mozee-motorsports/inverter-control-board/README.md

# mp7_ied (isolation-expansion-device)

Isolated CAN-addressable analog throttle for Sevcon.

- firmware in `src/`
  - to build: install Raspberry Pi Pico extension in vscode, open folder, click compile on bottom bar. 
- kicad project in `pcb/`
