mozee-motorsports/inverter-control-board/pcb/output/motorboard.step

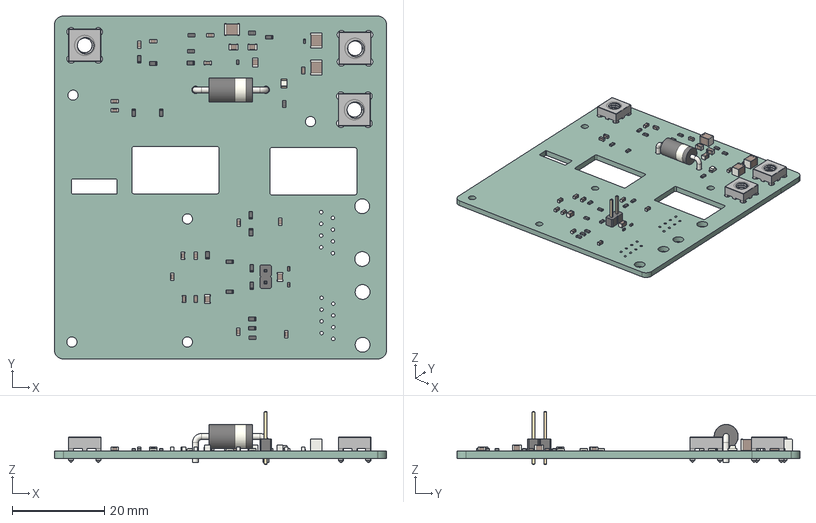
[picture p1: CAD file, 2025-04-10]
pcb/output/motorboard.step
72.0 x 74.3 x 11.5 mm
R_0603_1608Metric x 20
D_DO-201AD_P15.24mm_Horizontal
C_0603_1608Metric x 16
Wuerth_REDCUBE-THR_WP-THRBU_74650074_THR x 3
C_1210_3225Metric x 3
C_0805_2012Metric x 5
C_0402_1005Metric x 2
LED_0805_2012Metric
PinHeader_1x02_P254mm_Vertical
R_0402_1005Metric x 2
motorboard_PCB
