mozee-motorsports/inverter-control-board/todo.md

- [ ] output filtering on TSV 12V (LDO, LC filter?)
- [ ] Swap I2C for SPI
- [ ] rest of circuit
