mozee-motorsports/inverter-control-board/resources/Buck_Converter_Design_Report.pdf

## WEBENCH ® Design Report

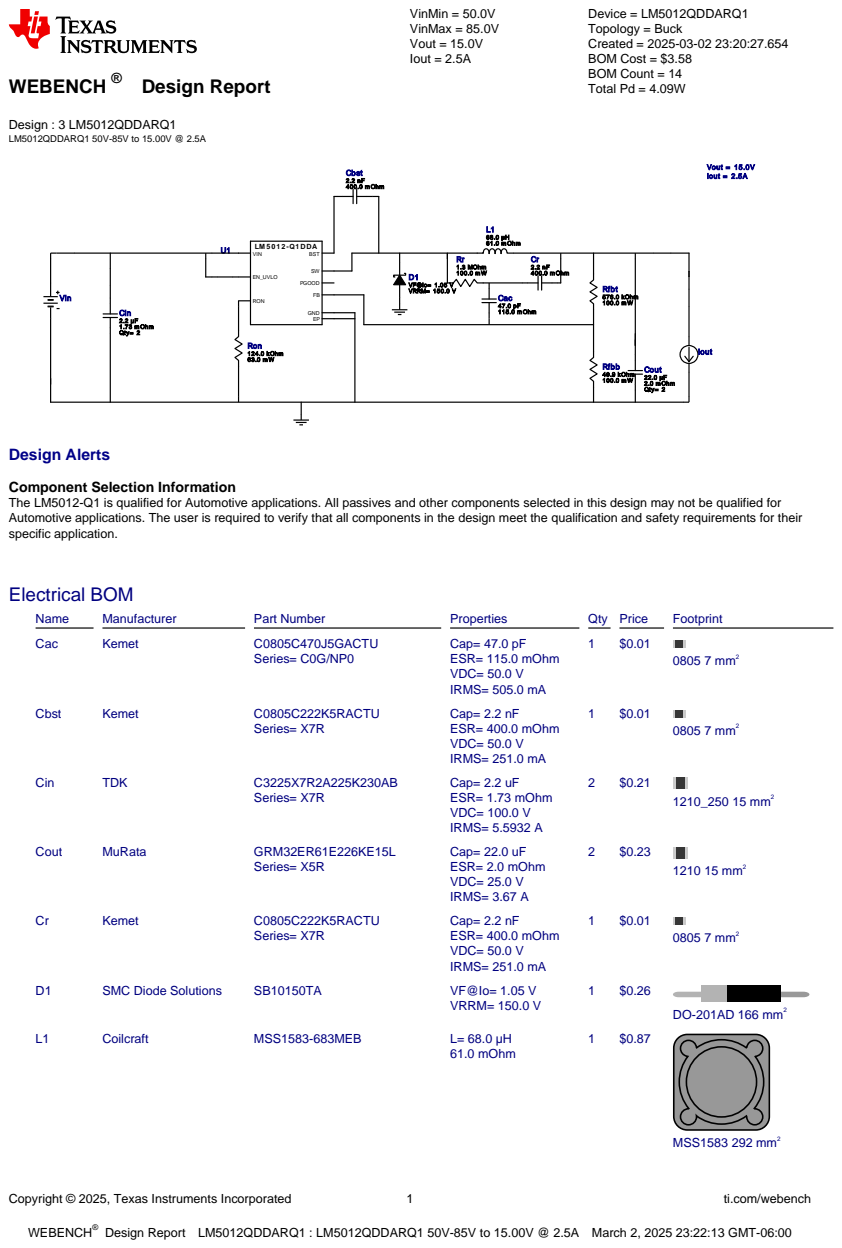
[picture p2: page 1]
Copyright © 2025, Texas Instruments Incorporated; ti.com/webench; WEBENCH®; Design : 3 LM5012QDDARQ1 LM5012QDDARQ1 50V-85V to 15.00V @ 2.5A; VinMin = 50.0V VinMax = 85.0V Vout = 15.0V Iout = 2.5A; Device = LM5012QDDARQ1 Topology = Buck Created = 2025-03-02 23:20:27.654 BOM Cost = $3.58 BOM Count = 14 Total Pd = 4.09W; Cbst 2.2 nF 400.0 m Ohm; LM 5 0 1 2 -Q1 DDA; GND; VIN; EN_UVLO; RON; PGOOD; BST; Cac 47.0 pF 115.0 m Ohm; Rr 1.3 MOhm 100.0 m W; Cr 2.2 nF 400.0 m Ohm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

Component Selection Information
The LM5012-Q1 is qualified for Automotive applications. All passives and other components selected in this design may not be qualified for
Automotive applications. The user is required to verify that all components in the design meet the qualification and safety requirements for their
specific application.

Design Report LM5012QDDARQ1 : LM5012QDDARQ1 50V-85V to 15.00V @ 2.5A March 2, 2025 23:22:13 GMT-06:00

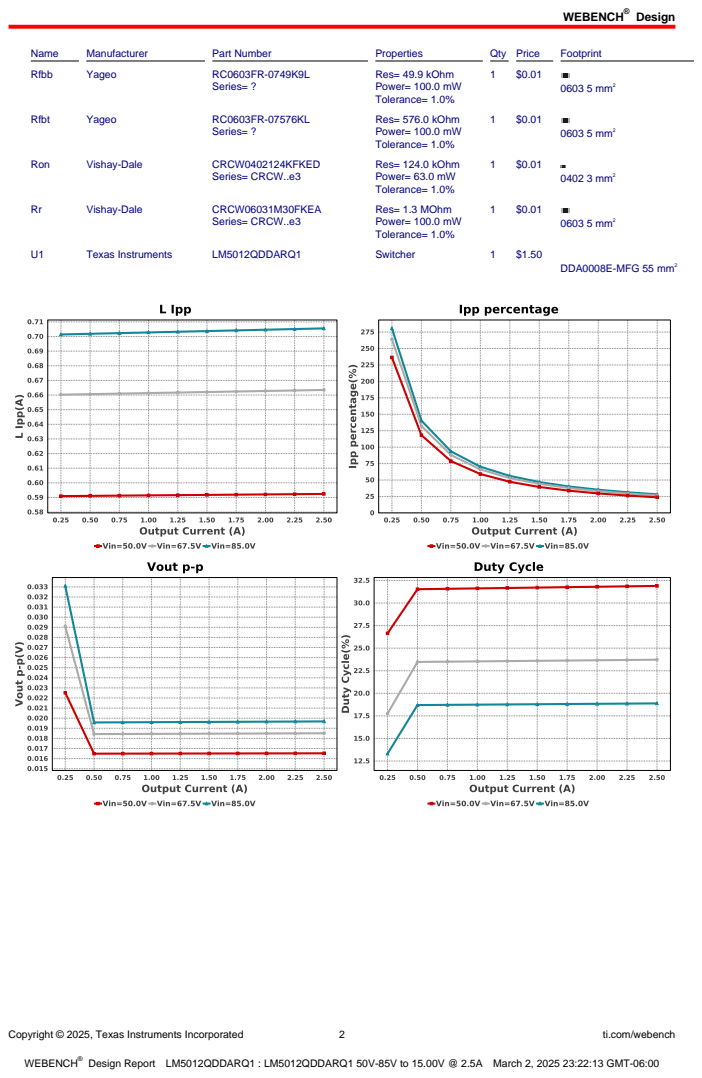
[picture p3: page 2]
Design; Copyright © 2025, Texas Instruments Incorporated; ti.com/webench; Name; Manufacturer; Part Number; Properties; Qty Price; Footprint; Rfbb; Yageo; Series= ?; Res= 49.9 kOhm Power= 100.0 mW Tolerance= 1.0%; 0603 5 mm²; Rfbt; Res= 576.0 kOhm Power= 100.0 mW Tolerance= 1.0%; Ron; Vishay-Dale; CRCW0402124KFKED; Series= CRCW..e3; Res= 124.0 kOhm Power= 63.0 mW Tolerance= 1.0%; 0402 3 mm²; CRCW06031M30FKEA; Res= 1.3 MOhm Power= 100.0 mW Tolerance= 1.0%; Texas Instruments; LM5012QDDARQ1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

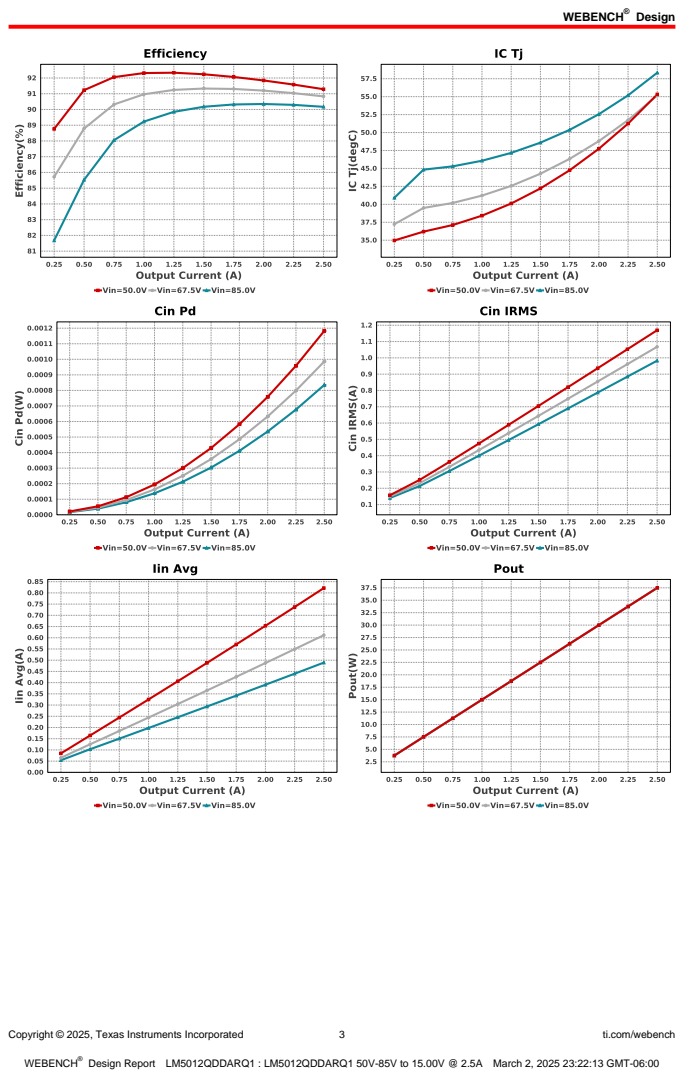
[picture p4: page 3]
Copyright © 2025, Texas Instruments Incorporated; ti.com/webench

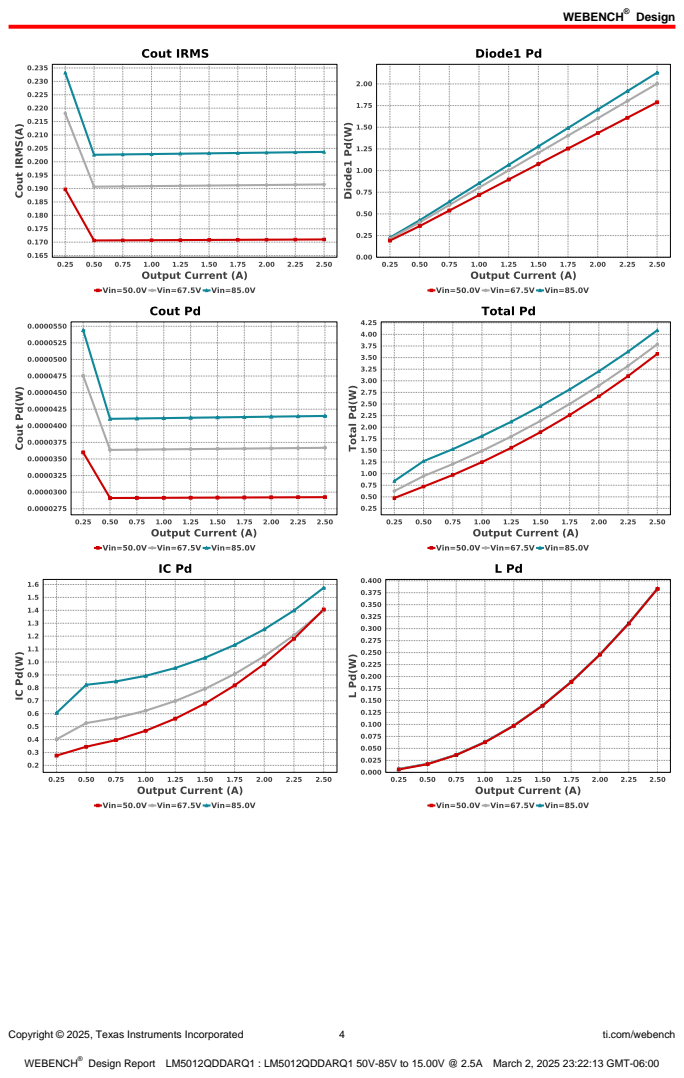
[picture p5: page 4]
Copyright © 2025, Texas Instruments Incorporated; ti.com/webench

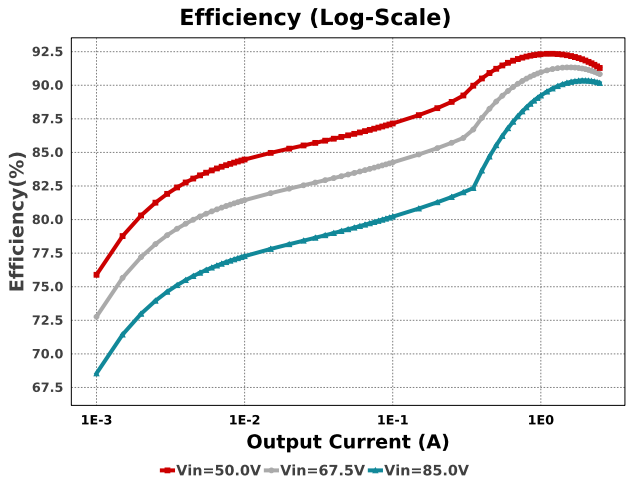
[picture p6: figure]

Copyright © 2025, Texas Instruments Incorporated | 5 | ti.com/webench

## Operating Values

# | Name | Value | Category | Description

1. Cin IRMS | 982.444 mA | Capacitor | Input capacitor RMS ripple current
2. Cin Pd | 834.89 µW | Capacitor | Input capacitor power dissipation
3. Cout IRMS | 203.681 mA | Capacitor | Output capacitor RMS ripple current
4. Cout Pd | 41.486 µW | Capacitor | Output capacitor power dissipation
5. Diode1 Pd | 2.129 W | Diode | Diode1 power dissipation
6. IC Pd | 1.574 W | IC | IC power dissipation
7. IC Tj | 58.336 degC | IC | IC junction temperature
8. IC Tolerance | 19.0 mV | IC | IC Feedback Tolerance
9. ICThetaJA | 18.0 degC/W | IC | IC junction-to-ambient thermal resistance
10. Iin Avg | 489.28 mA | IC | Average input current
11. Ipp percentage | 28.223 % | Inductor | Inductor ripple current percentage (with respect to average inductor
| | | | current)
12. L Ipp | 705.57 mA | Inductor | Peak-to-peak inductor ripple current
13. L Pd | 383.78 mW | Inductor | Inductor power dissipation
14. Cin Pd | 834.89 µW | Power | Input capacitor power dissipation
15. Cout Pd | 41.486 µW | Power | Output capacitor power dissipation
16. Diode1 Pd | 2.129 W | Power | Diode1 power dissipation
17. IC Pd | 1.574 W | Power | IC power dissipation
18. L Pd | 383.78 mW | Power | Inductor power dissipation
19. Total Pd | 4.089 W | Power | Total Power Dissipation
20. BOM Count | 14 | System
| | | Information | Total Design BOM count
21. Duty Cycle | 18.884 % | System
| | | Information | Duty cycle
22. Efficiency | 90.169 % | System
| | | Information | Steady state efficiency
23. FootPrint | 610.0 mm² | System
| | | Information | Total Foot Print Area of BOM components
24. Frequency | 273.931 kHz | System
| | | Information | Switching frequency
25. Iout | 2.5 A | System
| | | Information | Iout operating point
26. Mode | CCM | System
| | | Information | Conduction Mode
27. Pout | 37.5 W | System
| | | Information | Total output power
28. Total BOM | $3.58 | System
| | | Information | Total BOM Cost
29. Vin | 85.0 V | System
| | | Information | Vin operating point
30. Vout | 15.0 V | System
| | | Information | Operational Output Voltage
31. Vout Actual | 15.052 V | System
| | | Information | Vout Actual calculated based on selected voltage divider resistors
32. Vout Tolerance | 3.472 % | System
| | | Information | Vout Tolerance based on IC Tolerance (no load) and voltage divider resistors if applicable
33. Vout p-p | 19.682 mV | System
| | | Information | Peak-to-peak output ripple voltage

## Design Inputs

Copyright © 2025, Texas Instruments Incorporated | 6 | ti.com/webench
Name | Value | Description
Iout | 2.5 | Maximum Output Current
VinMax | 85.0 | Maximum input voltage
VinMin | 50.0 | Minimum input voltage
Vout | 15.0 | Output Voltage
base_pn | LM5012-Q1 | Base Product Number
source | DC | Input Source Type
Ta | 30.0 | Ambient temperature


Copyright © 2025, Texas Instruments Incorporated | 7 | ti.com/webench

## Assembly

## Component Testing

Some published data on components in datasheets such as Capacitor ESR and Inductor DC resistance is based on conservative values that will guarantee that the components always exceed the specification. For design purposes it is usually better to work with typical values. Since this data is not always available it is a good practice to measure the Capacitance and ESR values of Cin and Cout, and the inductance and DC resistance of L1 before assembly of the board. Any large discrepancies in values should be electrically simulated in WEBENCH to check for instabilities and thermally simulated in WebTHERM to make sure critical temperatures are not exceeded.

## Soldering Component to Board

If board assembly is done in house it is best to tack down one terminal of a component on the board then solder the other terminal. For surface mount parts with large tabs, such as the DPAK, the tab on the back of the package should be pre-tinned with solder, then tacked into place by one of the pins. To solder the tab town to the board place the iron down on the board while resting against the tab, heating both surfaces simultaneously. Apply light pressure to the top of the plastic case until the solder flows around the part and the part is flush with the PCB. If the solder is not flowing around the board you may need a higher wattage iron (generally 25W to 30W is enough).

## Initial Startup of Circuit

It is best to initially power up the board by setting the input supply voltage to the lowest operating input voltage 50.0V and set the input supply's current limit to zero. With the input supply off connect up the input supply to Vin and GND. Connect a digital volt meter and a load if needed to set the minimum Iout of the design from Vout and GND. Turn on the input supply and slowly turn up the current limit on the input supply.
If the voltage starts to rise on the input supply continue increasing the input supply current limit while watching the output voltage. If the current increases on the input supply, but the voltage remains near zero, then there may be a short or a component misplaced on the board. Power down the board and visually inspect for solder bridges and recheck the diode and capacitor polarities. Once the power supply circuit is operational then more extensive testing may include full load testing, transient load and line tests to compare with simulation results.

## Load Testing

The setup is the same as the initial startup, except that an additional digital voltmeter is connected between Vin and GND, a load is connected between Vout and GND and a current meter is connected in series between Vout and the load. The load must be able to handle at least rated output power + 50% ( 7.5 watts for this design). Ideally the load is supplied in the form of a variable load test unit. It can also be done in the form of suitably large power resistors. When using an oscilloscope to measure waveforms on the prototype board, the ground leads of the oscilloscope probes should be as short as possible and the area of the loop formed by the ground lead should be kept to a minimum. This will help reduce ground lead inductance and eliminate EMI noise that is not actually present in the circuit.

## Design Assistance

1. The LM5012-Q1 is qualified for Automotive applications. All passives and other components selected in this design may not be qualified for Automotive applications. The user is required to verify that all components in the design meet the qualification and safety requirements for their specific application
2. Master key : 540540835BFE532DA29369383AB8C5E5[v1]
3. LM5012-Q1 Product Folder : http://www.ti.com/product/LM5012%2DQ1 : contains the data sheet and other resources.

Copyright © 2025, Texas Instruments Incorporated | 8 | ti.com/webench

Important Notice and Disclaimer

TI provides technical and reliability data (including datasheets), design resources (including reference designs), application or other design advice, web tools, safety information, and other resources AS IS and with all faults, and disclaims all warranties. These resources are intended for skilled developers designing with TI products. You are solely responsible for (1) selecting the appropriate TI products for your application, (2) designing, validating and testing your application, and (3) ensuring your application meets applicable standards, and any other safety, security, or other requirements.

These resources are subject to change without notice. TI grants you permission to use these resources only for development of an application that uses the TI products described in the resource. Other reproduction and display of these resources is prohibited. No license is granted to any other TI intellectual property right or to any third party intellectual property right. TI disclaims responsibility for, and you will fully indemnify TI and its representatives against, any claims, damages, costs, losses, and liabilities arising out of your use of these resources.

Providing these resources does not expand or otherwise alter TI's applicable Terms of Sale or other applicable terms available either on ti.com or provided in conjunction with TI products.
