mozee-motorsports/inverter-control-board/pcb/motorboard.kicad_pcb

## KiCad design pcb/motorboard.kicad_pcb (2025-04-21)

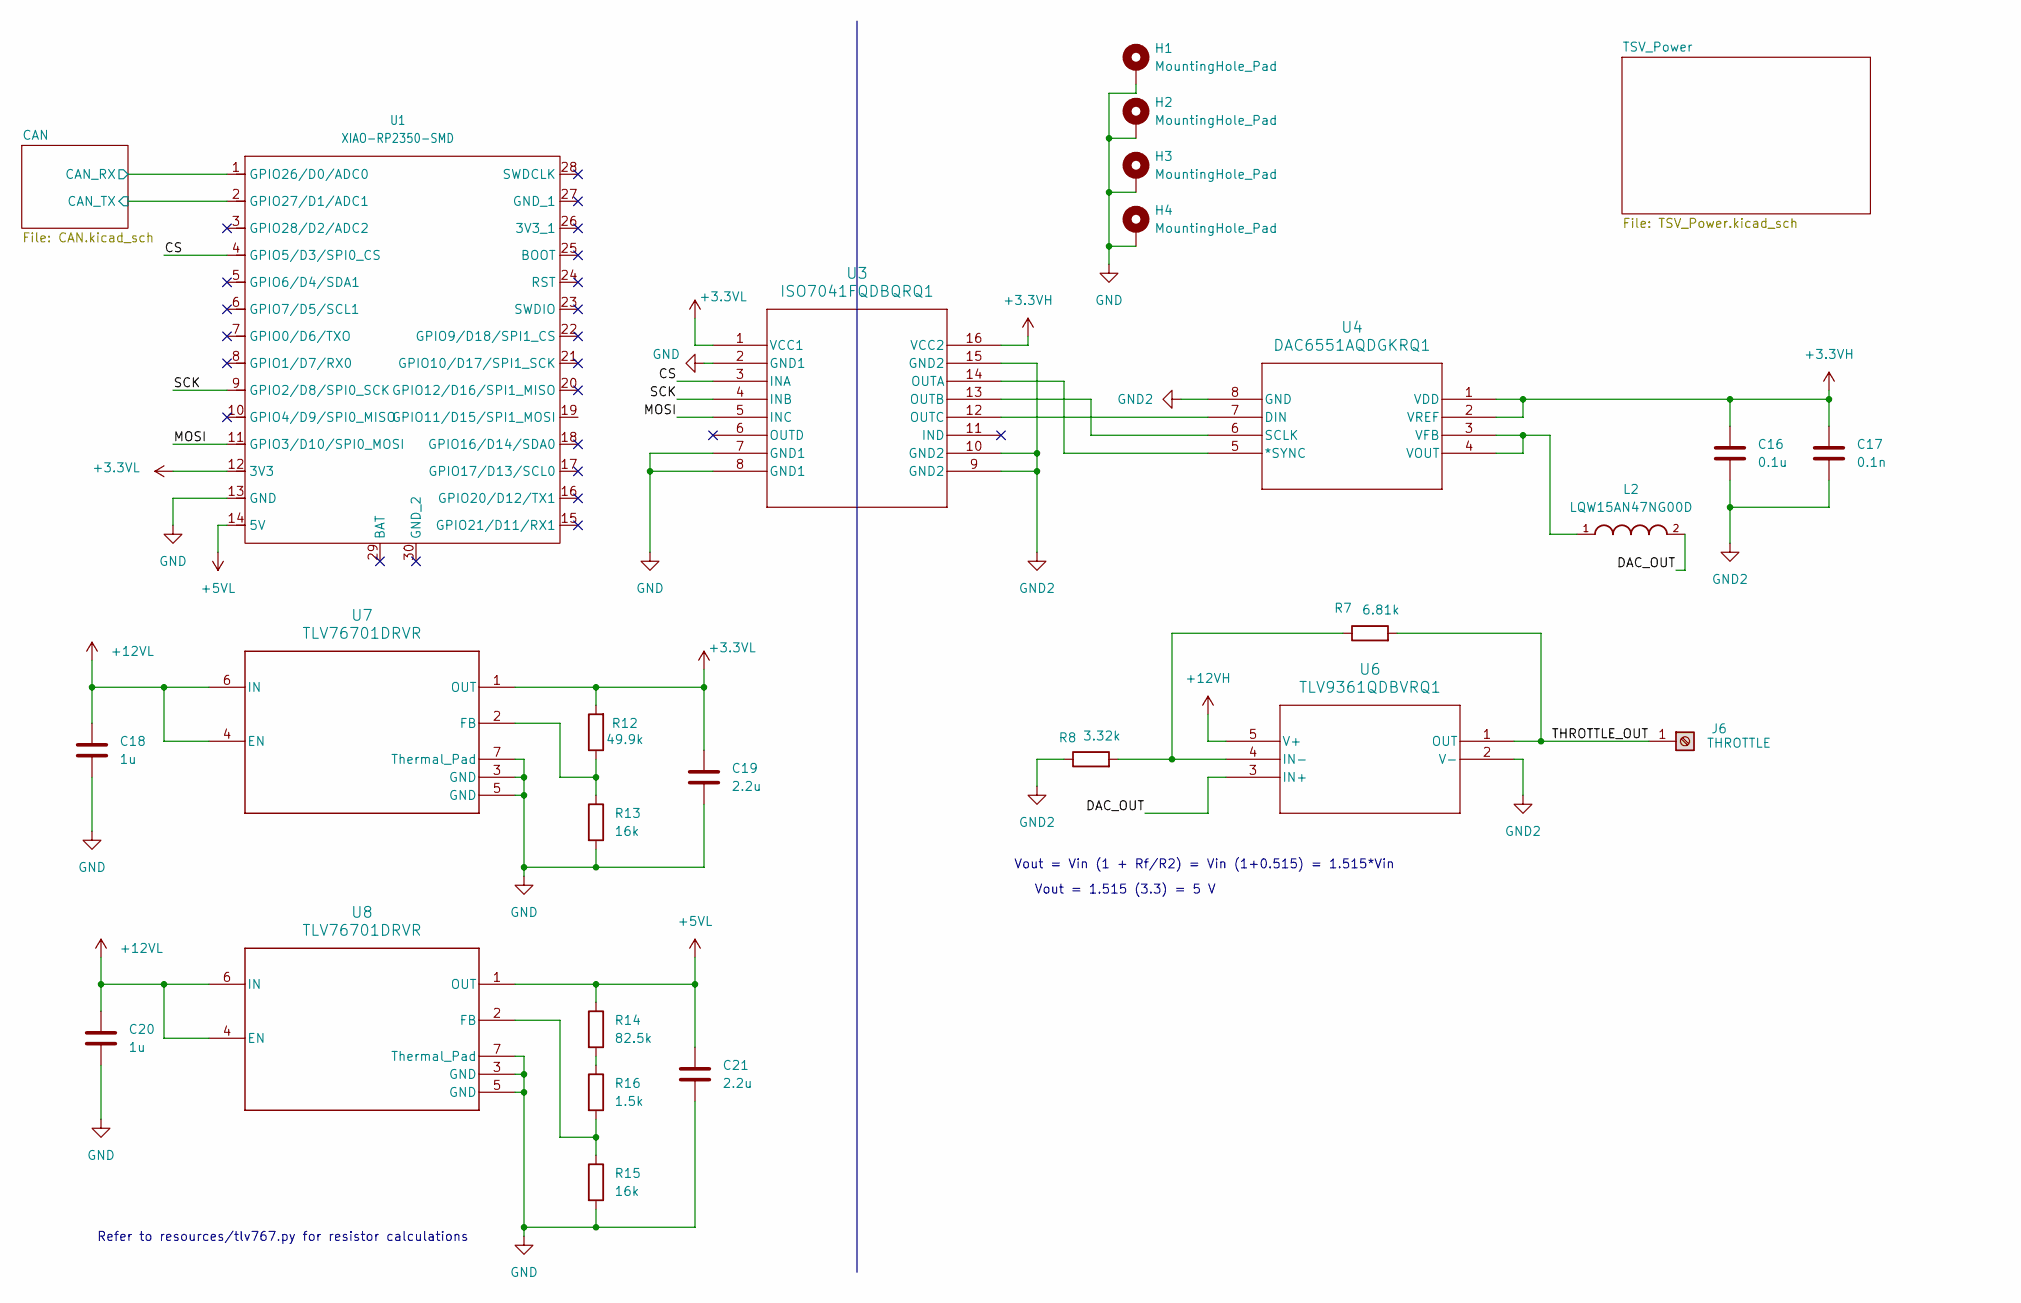
[picture p8: schematic motorboard.kicad_sch]

Parts:
C16: 0.1u; C_0603_1608Metric
C17: 0.1n; C_0603_1608Metric
C18, C20: 1u; C_0603_1608Metric
C19, C21: 2.2u; C_0603_1608Metric
H1, H2, H3, H4: MountingHole_Pad; MountingHole_2.2mm_M2
J6: THROTTLE; Wuerth_REDCUBE-THR_WP-THRBU_74650074_THR
L2: LQW15AN47NG00D; INDC1005X60N
R7: 6.81k; R_0603_1608Metric
R8: 3.32k; R_0603_1608Metric
R12: 49.9k; R_0603_1608Metric
R13, R15: 16k; R_0603_1608Metric
R14: 82.5k; R_0603_1608Metric
R16: 1.5k; R_0603_1608Metric
U1: XIAO-RP2350-SMD
U3: ISO7041FQDBQRQ1; SSOP16_DBQ_TEX
U4: DAC6551AQDGKRQ1; DGK8_TEX
U6: TLV9361QDBVRQ1; SOT23_DBV_TEX
U7, U8: TLV76701DRVR; DRV0006A-IPC_A

Connections:
+3.3VH: C16.1, C17.1, U3.16 (VCC2), U4.1 (VDD), U4.2 (VREF); also elsewhere on the board
+3.3VL: C19.1, R12.2, U1.12 (3V3), U3.1 (VCC1), U7.1 (OUT); also elsewhere on the board
+5VL: C21.1, R14.1, U1.14 (5V), U8.1 (OUT); also elsewhere on the board
+12VH: U6.5 (V+); also elsewhere on the board
+12VL: C18.1, C20.1, U7.4 (EN), U7.6 (IN), U8.4 (EN), U8.6 (IN); also elsewhere on the board
/CAN/CAN_RX: U1.1 (GPIO26/D0/ADC0); also elsewhere on the board
/CAN/CAN_TX: U1.2 (GPIO27/D1/ADC1); also elsewhere on the board
/CS: U1.4 (GPIO5/D3/SPI0_CS), U3.3 (INA)
/DAC_OUT: L2.2, U6.3 (IN+)
/MOSI: U1.11 (GPIO3/D10/SPI0_MOSI), U3.5 (INC)
/SCK: U1.9 (GPIO2/D8/SPI0_SCK), U3.4 (INB)
/THROTTLE_OUT: J6.1, R7.2, U6.1 (OUT)
GND: C18.2, C19.2, C20.2, C21.2, H1.1, H2.1, H3.1, H4.1, R13.2, R15.2, U1.13 (GND), U3.2 (GND1), U3.7 (GND1), U3.8 (GND1), U7.3 (GND), U7.5 (GND), U7.7 (Thermal_Pad), U8.3 (GND), U8.5 (GND), U8.7 (Thermal_Pad); also elsewhere on the board
GND2: C16.2, C17.2, R8.1, U3.9 (GND2), U3.10 (GND2), U3.15 (GND2), U4.8 (GND), U6.2 (V-); also elsewhere on the board
unnamed: R14.2, R16.1
unnamed: U3.14 (OUTA), U4.5 (*SYNC)
unnamed: U3.13 (OUTB), U4.6 (SCLK)
unnamed: U3.12 (OUTC), U4.7 (DIN)
unnamed: L2.1, U4.3 (VFB), U4.4 (VOUT)
unnamed: R7.1, R8.2, U6.4 (IN-)
unnamed: R12.1, R13.1, U7.2 (FB)
unnamed: R15.1, R16.2, U8.2 (FB)

Notes on the sheet:
Vout = 1.515 (3.3) = 5 V
Refer to resources/tlv767.py for resistor calculations
Vout = Vin (1 + Rf/R2) = Vin (1+0.515) = 1.515*Vin

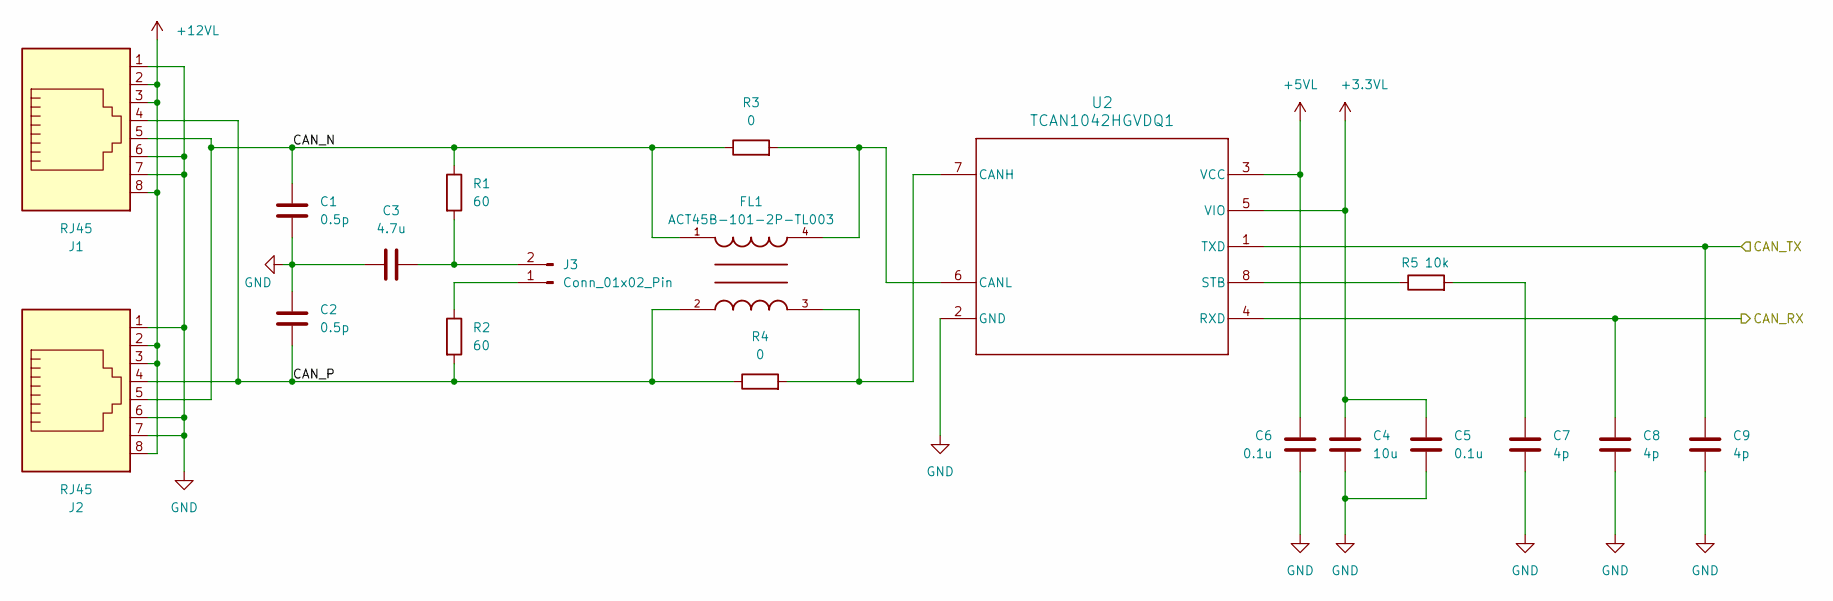
[picture p9: schematic CAN.kicad_sch]

Parts:
C1, C2: 0.5p; C_0402_1005Metric
C3: 4.7u; C_0805_2012Metric
C4: 10u; C_0805_2012Metric
C5, C6: 0.1u; C_0603_1608Metric
C7, C8, C9: 4p; C_0603_1608Metric
FL1: ACT45B-101-2P-TL003; FIL_ACT45B-101-2P-TL003; PARTREV 20200405
J1, J2: RJ45; RJ45_Amphenol_54602-x08_Horizontal
J3: Conn_01x02_Pin; PinHeader_1x02_P2.54mm_Vertical
R1, R2: 60; R_0603_1608Metric
R3, R4: 0; R_0603_1608Metric
R5: 10k; R_0603_1608Metric
U2: TCAN1042HGVDQ1; D0008A_L

Connections:
+3.3VL: C4.1, C5.1, U2.5 (VIO); also elsewhere on the board
+5VL: C6.2, U2.3 (VCC); also elsewhere on the board
+12VL: J1.2, J1.3, J1.8, J2.2, J2.3, J2.8; also elsewhere on the board
/CAN/CAN_N: C1.2, FL1.1, J1.5, J2.5, R1.1, R3.1
/CAN/CAN_P: C2.1, FL1.2, J1.4, J2.4, R2.2, R4.1
/CAN/CAN_RX: C8.1, U2.4 (RXD); also elsewhere on the board
/CAN/CAN_TX: C9.1, U2.1 (TXD); also elsewhere on the board
GND: C1.1, C2.2, C3.2, C4.2, C5.2, C6.1, C7.2, C8.2, C9.2, J1.1, J1.6, J1.7, J2.1, J2.6, J2.7, U2.2 (GND); also elsewhere on the board
unnamed: C7.1, R5.2
unnamed: J3.1, R2.1
unnamed: C3.1, J3.2, R1.2
unnamed: FL1.3, R4.2, U2.7 (CANH)
unnamed: FL1.4, R3.2, U2.6 (CANL)
unnamed: R5.1, U2.8 (STB)

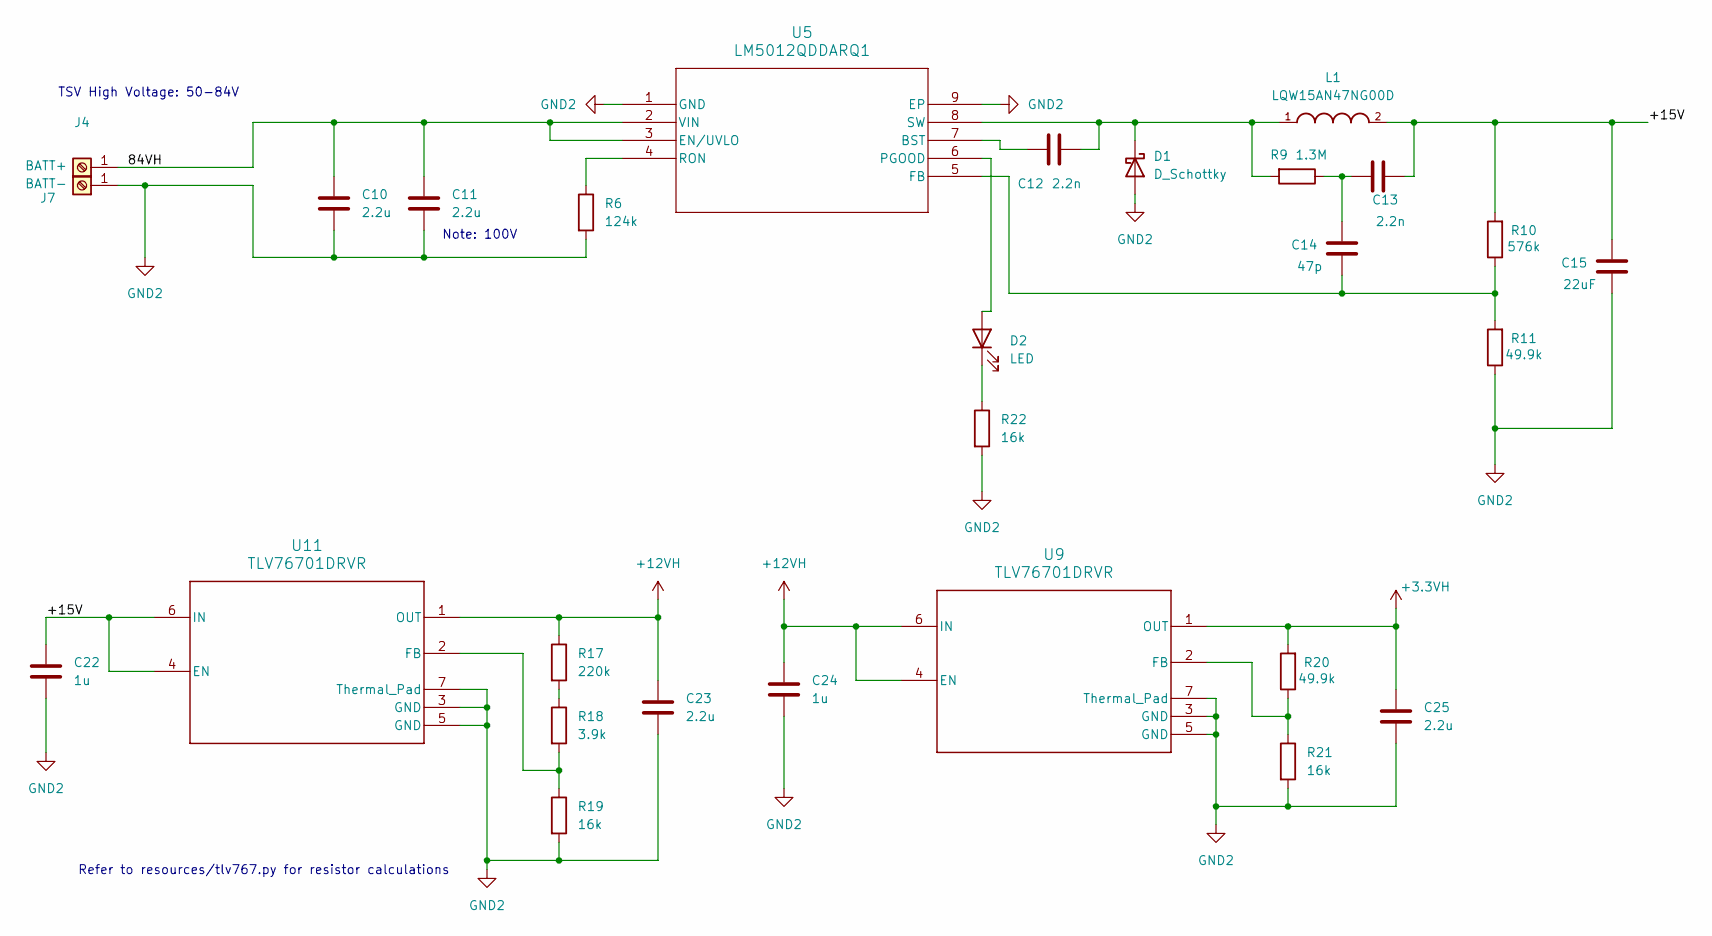
[picture p10: schematic TSV_Power.kicad_sch]

Parts:
C10, C11: 2.2u; C_1210_3225Metric_Pad1.33x2.70mm_HandSolder
C12, C13: 2.2n; C_0805_2012Metric
C14: 47p; C_0805_2012Metric
C15: 22uF; C_1210_3225Metric
C22, C24: 1u; C_0603_1608Metric
C23, C25: 2.2u; C_0603_1608Metric
D1: D_Schottky; D_DO-201AD_P15.24mm_Horizontal
D2: LED; LED_0805_2012Metric
J4: BATT+; Wuerth_REDCUBE-THR_WP-THRBU_74650074_THR
J7: BATT-; Wuerth_REDCUBE-THR_WP-THRBU_74650074_THR
L1: LQW15AN47NG00D; INDC1005X60N
R6: 124k; R_0402_1005Metric
R9: 1.3M; R_0402_1005Metric_Pad0.72x0.64mm_HandSolder
R10: 576k; R_0603_1608Metric
R11, R20: 49.9k; R_0603_1608Metric
R17: 220k; R_0603_1608Metric
R18: 3.9k; R_0603_1608Metric
R19, R21, R22: 16k; R_0603_1608Metric
U5: LM5012QDDARQ1; SO-8-DDA_TEX
U9, U11: TLV76701DRVR; DRV0006A-IPC_A

Connections:
+3.3VH: C25.1, R20.2, U9.1 (OUT); also elsewhere on the board
+12VH: C23.1, C24.1, R17.1, U9.4 (EN), U9.6 (IN), U11.1 (OUT); also elsewhere on the board
/TSV_Power/84VH: C10.1, C11.1, J4.1, U5.2 (VIN), U5.3 (EN/UVLO); also elsewhere on the board
/TSV_Power/+15V: C13.2, C15.1, C22.1, L1.2, R10.2, U11.4 (EN), U11.6 (IN)
GND2: C10.2, C11.2, C15.2, C22.2, C23.2, C24.2, C25.2, D1.2 (A), J7.1, R6.2, R11.1, R19.2, R21.2, R22.2, U5.1 (GND), U5.9 (EP), U9.3 (GND), U9.5 (GND), U9.7 (Thermal_Pad), U11.3 (GND), U11.5 (GND), U11.7 (Thermal_Pad); also elsewhere on the board
unnamed: C13.1, C14.1, R9.1
unnamed: C12.2, D1.1 (K), L1.1, R9.2, U5.8 (SW)
unnamed: D2.2 (A), U5.6 (PGOOD)
unnamed: D2.1 (K), R22.1
unnamed: R17.2, R18.1
unnamed: C12.1, U5.7 (BST)
unnamed: C14.2, R10.1, R11.2, U5.5 (FB)
unnamed: R6.1, U5.4 (RON)
unnamed: R20.1, R21.1, U9.2 (FB)
unnamed: R18.2, R19.1, U11.2 (FB)

Notes on the sheet:
Refer to resources/tlv767.py for resistor calculations
Note: 100V
TSV High Voltage: 50-84V

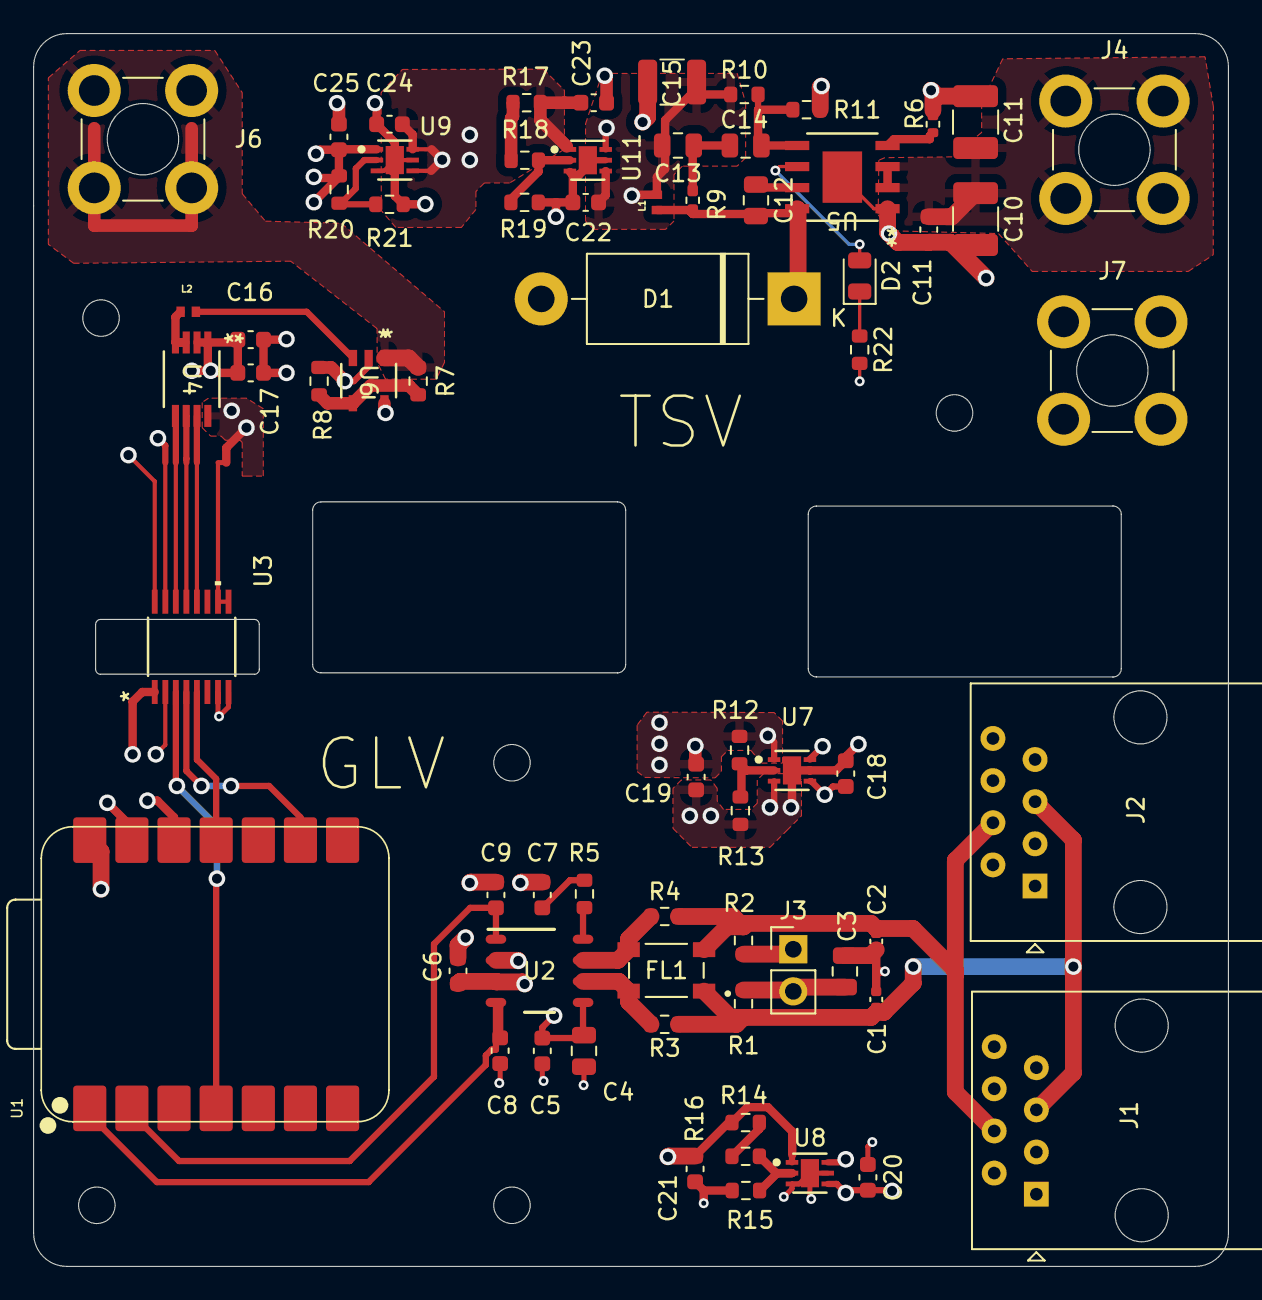
[picture p11: board motorboard.kicad_pcb from above]

Board: 4 copper layers, 72.0 x 74.3 mm, 74 parts (0 on the bottom side), 42 nets.

Other parts of the board:
C11#2: 2.2u; C_1210_3225Metric_Pad1.33x2.70mm_HandSolder
H3#2: MountingHole_Pad; MountingHole_2.2mm_M2

Their connections:
/TSV_Power/84VH: C11#2.1; also elsewhere on the board
GND2: C11#2.2; also elsewhere on the board
