mozee-motorsports/inverter-control-board/(commit log)

2025-03-03 switch isolator for SPI, output stage (DAC, op amp)
    [CAN.kicad_sch, TSV_Power.kicad_sch, motorboard.kicad_sch]
2025-03-03 Schematic done, pending review
    [CAN.kicad_sch, TSV_Power.kicad_sch, XIAO-RP2350-pinout-sheet.xlsx, motorboard.kicad_sch]
2025-03-04 Initial layout, all resistors/caps are 0602
    [CAN.kicad_sch, TSV_Power.kicad_sch, motorboard.kicad_pcb, motorboard.kicad_sch]
2025-03-11 layout finished, silkscreen finished, BOM finished
    [CAN.kicad_sch, TSV_Power.kicad_sch, digikey_bom.xlsx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]
2025-04-10 pcb that we ordered with
    [BOM2.csv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]
2025-04-21 basic firmware, CAN consumption -> DAC only, no frame format
    [CAN.kicad_sch, TSV_Power.kicad_sch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]
2025-04-21 CAN frame format
